Fasermaler/Motion-Activated-TV/Wiring_Image.jpg

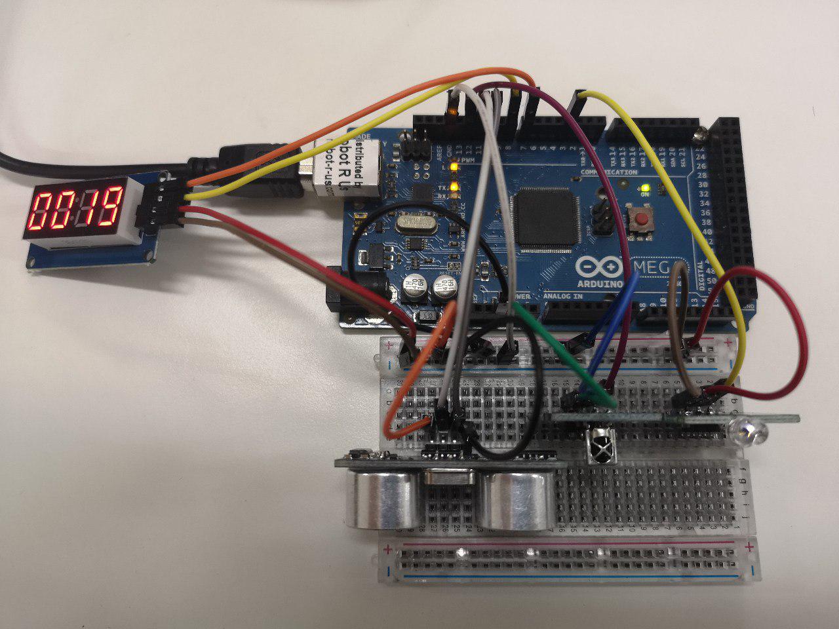
Wiring_Image.jpg
